TFmini/TFmini2JSRZ/Assets/miniU2S.png

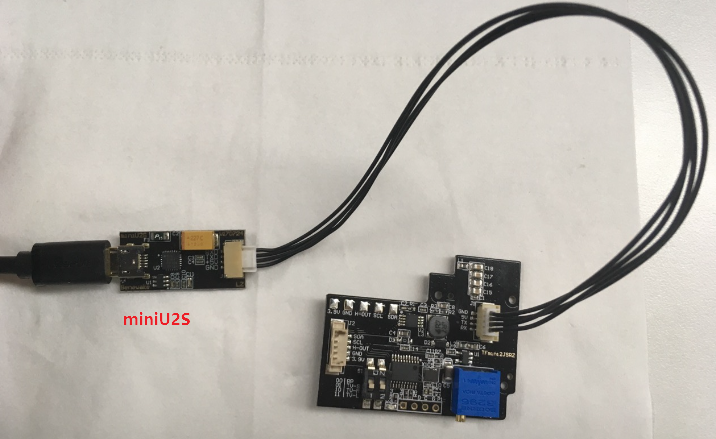
Assets/miniU2S.png
