TFmini/TFmini2JSRZ/Assets/sscom.png

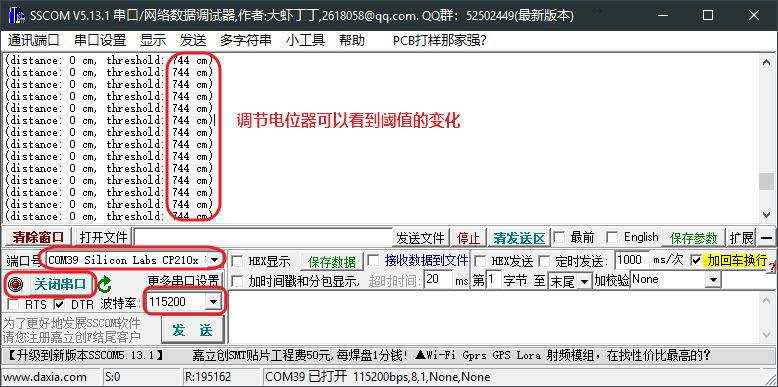
Assets/sscom.png
