TFmini/TFmini2JSRZ/TFmini2JSRZ_BOM.xls

文件名称：TFmini2JSRZ物料清单 文件编号： 版本：V180301
产品名称：TFmini2JSRZ PCBA 规格型号：TFmini2JSRZ 焊接工艺：无铅焊接
序号 | 物料编码 | 品牌 | 名称 | 规格型号 | 厂家型号 | 单位 | 用量 | 器件标号 | 备注
1 |  |  | TFmini2JSRZ PCB | TFmini2JSRZ_V180301 |  | 块 | 20 |  |  | 20套数量 | 需求数量 | 采购确认采购数量 | 确认到货时间
2 |  |  | 贴片电容 | 100nF 0402 10% 25V |  | 个 | 3 | C1, C13, C14 |  | 60
3 |  |  | 贴片电容 | 2.2nF 0402 10% 50V |  | 个 | 1 | C2 |  | 20
4 |  |  | 贴片电容 | 10nF 0402 10% 50V |  | 个 | 2 | C3, C7 |  | 40
5 |  |  | 贴片电容 | 10uF 0603 20% 16V |  | 个 | 3 | C4, C6, C8 |  | 60
6 |  |  | 贴片电容 | 22uF 3216 10% 10V |  | 个 | 1 | C5 |  | 20
7 |  |  | 贴片电容 | 20pF 0402 5% 50V |  | 个 | 2 | C9, C10 |  | 40
8 |  |  | 贴片电容 | 1uF 0402 10% 16V |  | 个 | 1 | C11 |  | 20
9 |  |  | 贴片电容 | 10uF 0402 20% 10V |  | 个 | 1 | C12 |  | 20
10 |  |  | 贴片电容 | 47uF 0805 20% 10V |  | 个 | 4 | C15, C16, C17, C18 |  | 80
11 |  |  | 贴片二极管 | SOD-123F | DSS24 | 个 | 2 | D1, D2 |  | 40
12 |  |  | LED | 0603 | RED | 个 | 1 | D3 |  | 20
13 |  |  | 带锁扣接插件 | GH1.25-4P 立贴 |  | 个 | 1 | J1 |  | 20
14 |  |  | 接插件 | MH1.25-5P 立贴 |  | 个 | 1 | J2 |  | 20
15 |  |  | 磁珠 | 0603 | BLM18PG331SN1D | 个 | 2 | L1, L2 |  | 40
16 |  |  | 贴片电感 | 5*5*2 | FNR5020S4R7MT / LQH5BPN4R7NT0L / NRS4018T4R7MDGJ | 个 | 1 | L3 |  | 20
17 |  |  | 贴片电阻 | 10K 0402 1% |  | 个 | 7 | R1, R3, R4, R5, R6, R7, R8 |  | 140
18 |  |  | 贴片电阻 | 30K 0402 1% |  | 个 | 1 | R2 |  | 20
19 |  |  | 电位器 | 10K 3296P | 3296P | 个 | 1 | RP1 |  | 20
20 |  |  | 贴片拨码开关 | 2.54mm 2位 | DSIC02LSGET | 个 | 1 | S1 |  | 20
21 |  |  |  | TEST | 测试点不焊 | 个 | 5 | T1, T2, T3, T4, T5 |  | 100
22 |  |  | 集成电路 | SOT23-5 | SP6205EM5-L-3-3 | 个 | 1 | U1 |  | 20
23 |  |  | 集成电路 | MSOP-8 | MP1542DK | 个 | 1 | U2 |  | 20
24 |  |  | 集成电路 | TSSOP20 | STM32F030F4P6 | 个 | 1 | U3 |  | 20
25 |  |  | 贴片晶振 | 3225 4脚 | 8M | 个 | 1 | X1 |  | 20
26 |  |  | 排针 | 2.54mm 40P |  | 包 | 1/20 |  |  | 1
27 |  |  | 排线 | MH1.25排线 5P 15cm 同向反向各1条 |  | 条 | 2 |  |  | 40
28 |  |  | 排线 | GH1.25排线 4P 10cm 同向反向各1条 |  | 条 | 2 |  |  | 40
