TFmini/TFmini2JSRZ/TFmini2JSRZ制板说明.xls

文件名称：TFmini2JSRZ制板说明 |  | 文件编号： |  | 版本：V180301
项目代码：
PCB型号(P/N)： |  |  |  |  | 光板
文件格式及版本： |  | 其它： |  |  | 单面板 | 刚性板 | GERBER | FR4(普通） | 0.4 | 18um/0.5oz | 有铅喷锡 | 按文件设计 |  |  |  | 不印 | 是 | 加
板材类型： |  | 其它： |  | 具体型号: | 双面板 | 挠性板 | powerpcb | FR4 高TG 170度 | 0.5 | 35um/1oz | 无铅喷锡 | 阻焊覆盖 | 只印顶层 | 绿色亮光 | 白色 | 印顶层 | 否 | 不加
完成板厚(mm)： | 1.0 | 层数： |  | 其它: | 3层 | 刚挠板 | pads2005 | FR4 无卤素 | 0.6 | 70um/2oz | 有铅喷锡+金手指 | 阻焊塞孔 | 只印底层 | 绿色亚光 | 黄色 | 印底层 |  |  | 单拼交货 | IPC-A-600G I级
内层完成铜厚： |  | 其它： |  |  | 4层 | 盲埋孔 | protel 99se | FR4 无卤素+高TG | 0.7 | 105um/3oz | 无铅喷锡+金手指 | 不盖阻焊 | 双面印 | 黑色 | 黑色 | 印双面 |  |  | 拼板但铣开交货 | IPC-A-600G II级
外层完成铜厚： |  | 其它： |  |  | 5层 | HDI | protel 99 | Rogers | 0.8 | 140um/4oz | 水金 | BGA位塞孔+其它按文件设计 | 不印 | 黄色 | 其它 |  |  |  | V-CUT连片 | IPC-A-600G III级
表面处理： |  | 其它： |  |  | 6层 |  | AD09 | Arlon | 0.9 | 175um/5oz | 沉金 | 其它 |  | 白色 |  |  |  |  | 桥连 | GJB362A-96
过孔阻焊处理方式： |  | 其它： |  |  | 7层 |  | protel dxp 2004 | Tyconic | 1.0 | 210um/6oz | 水金+金手指 |  |  | 红色 |  |  |  |  | 桥连邮票孔 | 华为标准 | 5
阻焊： |  | 阻焊颜色： |  | 其它: | 8层 |  | protel dxp 6.3 | NELCO | 1.2 | 其它 | 沉金+金手指 |  |  | 蓝色 |  |  |  |  | V-CUT+桥连 | 中兴标准 | 10%
字符： |  | 字符颜色： |  | 其它: | 10层 |  | protel for windows | 其它 | 1.6 |  | 沉锡 |  |  | 其它 |  |  |  |  | V-CUT+桥连邮票孔 | 其它
可剥阻焊（蓝胶）： |  | 碳 油： |  |  | 12层 |  | protel for dos |  | 1.8 |  | 沉银 |  |  |  |  |  |  |  | 其它
手指(接触插头)倒角： |  | 顾客标记： |  |  | 14层 |  | CAM350 |  | 2.0 |  | OSP/防氧化处理
快捷标记（ul+logo）： |  | 周期标记： |  |  | 16层 |  | GCCAM |  | 2.4 |  | OSP+沉金
拼板方式： |  | PCB验收标准： |  | 其它: | 18层 |  | 其它 |  | 3.0 |  | 其它
拼板尺寸（mm）： |  | 单板尺寸（mm）： | 37.2*46 |  | 20层 |  |  |  | 3.2
拼板内单板数： | 1*2 | 阻抗控制： |  |  | 其它
焊盘与孔径等大（即内、外径相同）的孔，按非金属化孔（NPTH)制作：
同意 不同意，必须确认
无铅标记（Pb禁止标记)： 加， 不加。
无铅喷锡、镀金、沉金、沉银、沉锡、OSP工艺的板，默认添加该标记
多层板叠层顺序与阻抗要求：以下叠层顺序是从顶层（TOP层）来看
文件名 | 板材类型 | 控制阻抗的线宽/间距 |  | 阻抗要求(ohm)
Top Layer： | 默认 | 默认 | 默认 | 默认
Bottom Layer：
其它特别要求备注区域:
1、拼板留工艺边，加定位孔，板内 Mark 点 。 2、金属化孔壁铜层最小厚度＞25um；
交货随附资料: | 电测报告 | 阻抗测试报告 | 出货报告 | 菲林
 | 其它:
提供贴片钢网文件:
编制： |  | 审核： |  | 批准：
