TFmini/TFmini2JSRZ/TFmini2JSRZ_SCH.pdf

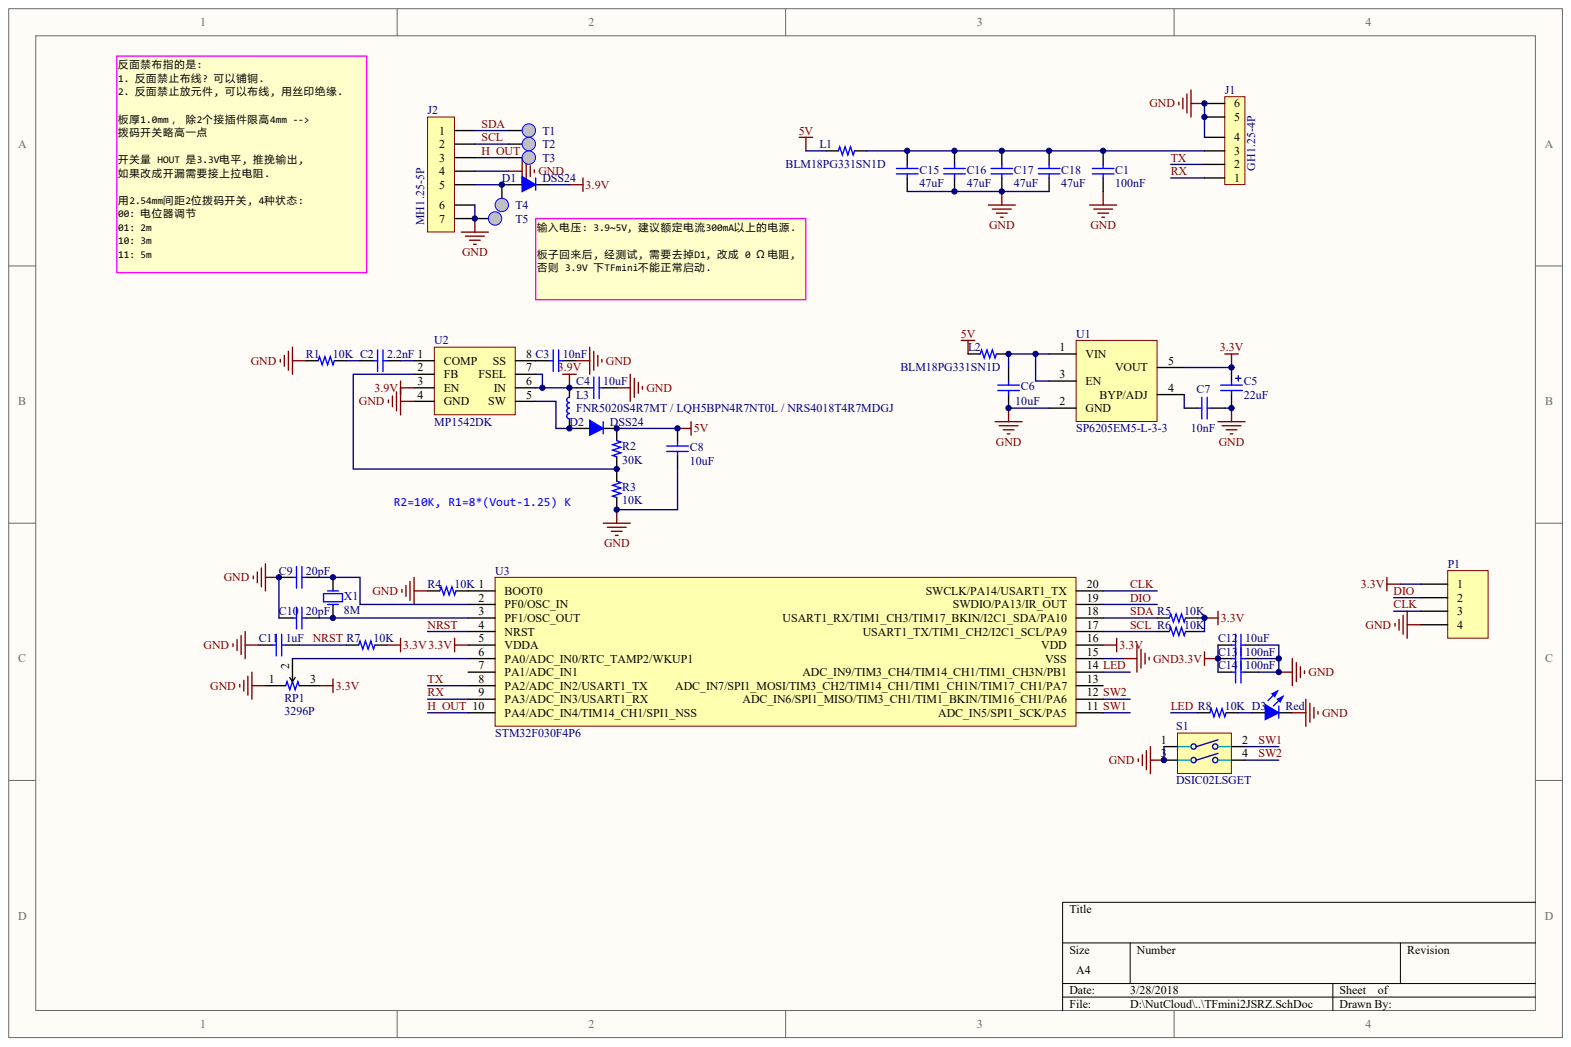
[picture p5: page 1]

FB 2 | | 3.9V
EN 3

Size A4 | Number | Revision

Date: 3/28/2018 | Sheet of
File: D:\NutCloud\..\TFmini2JSRZ.SchDoc | Drawn By:
