TFmini/TFmini2JSRZ/TFmini2JSRZ_Slave/TFmini2JSRZ_Slave.ioc

Mcu.UserName=STM32F030F4Px
PA0.Signal=ADC_IN0
PA10.Signal=I2C1_SDA
PA13.Signal=SYS_SWDIO
PA14.Signal=SYS_SWCLK
PA2.Signal=USART1_TX
PA3.Signal=USART1_RX
PA4.GPIO_Label=HOUT
PA4.Signal=GPIO_Output
PA5.GPIO_Label=SW1
PA5.Signal=GPXTI5
PA6.GPIO_Label=SW2
PA6.Signal=GPXTI6
PA9.Signal=I2C1_SCL
PB1.GPIO_Label=LED
PB1.Signal=GPIO_Output
PF0-OSC_IN.Signal=RCC_OSC_IN
PF1-OSC_OUT.Signal=RCC_OSC_OUT
