TFmini/TFmini2JSRZ/(notices)

Notices in the files:
TFmini2JSRZ_Slave/Src/main.c:
(C) COPYRIGHT STMicroelectronics *****END OF FILE
